r0b0t1cu/Pi1541-Simple-HAT/pi1541-simple/production/bom.csv

Designator | Footprint | Quantity | Value | LCSC Part #
D1 | LED_D3.0mm | 1 | ACT
D2 | LED_D3.0mm | 1 | PWR
J1 | PinSocket_2x20_P2.54mm_Vertical | 1 | GPIO
J2 | PinHeader_1x04_P2.54mm_Vertical | 1 | I2C Display Connector
J3 | DIN-6 | 1 | IEC1
J4 | PinHeader_1x06_P2.54mm_Vertical | 1 | IEC2
JP1 | PinHeader_1x02_P2.54mm_Vertical | 1 | BZR
LS1 | Buzzer_D12mm_H9mm_P6.5mm | 1 | Buzzer
R1, R2 | R_Axial_DIN0207_L6.3mm_D2.5mm_P10.16mm_Horizontal | 2 | 1k
SW1 | SW_Tactile_SPST_Angled_PTS645Vx83-2LFS | 1 | Select/Start
SW2 | SW_Tactile_SPST_Angled_PTS645Vx83-2LFS | 1 | Up
SW3 | SW_Tactile_SPST_Angled_PTS645Vx83-2LFS | 1 | Down
SW4 | SW_Tactile_SPST_Angled_PTS645Vx83-2LFS | 1 | Exit Folder
SW5 | SW_Tactile_SPST_Angled_PTS645Vx83-2LFS | 1 | Insert
SW6 | SW_PUSH_6mm | 1 | Reset
U1 | CONV_BOB-12009 | 1 | Level Shifter
