r0b0t1cu/Pi1541-Simple-HAT/pi1541-simple/pi1541-simple.kicad_pcb

## KiCad design pi1541-simple/pi1541-simple.kicad_pcb (2026-06-11)

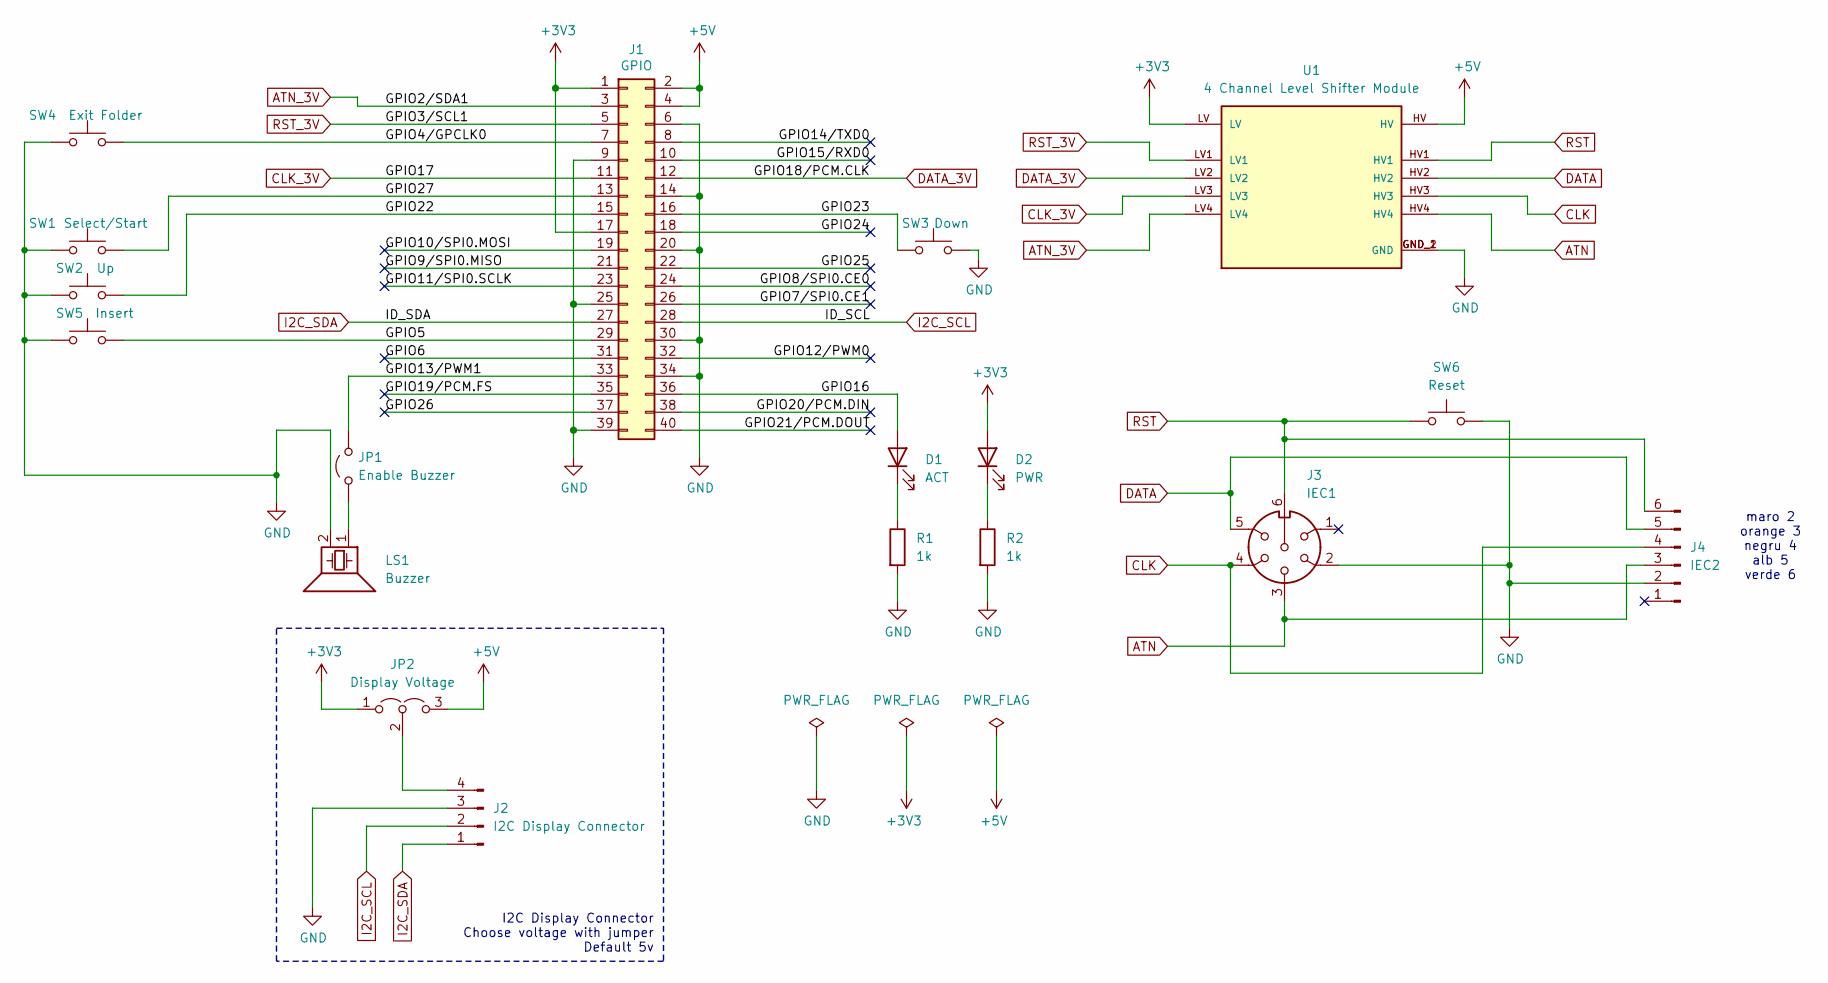
[picture p3: schematic pi1541-simple.kicad_sch, Pi1541]

Parts:
D1: ACT; LED_D3.0mm
D2: PWR; LED_D3.0mm
J1: GPIO; PinSocket_2x20_P2.54mm_Vertical
J2: I2C Display Connector; PinHeader_1x04_P2.54mm_Vertical
J3: IEC1; DIN-6
J4: IEC2; PinHeader_1x06_P2.54mm_Vertical
JP1: Enable Buzzer; PinHeader_1x02_P2.54mm_Vertical
JP2: Display Voltage; PinHeader_1x03_P2.54mm_Vertical
LS1: Buzzer; Buzzer_D14mm_H7mm_P10mm
R1, R2: 1k; R_Axial_DIN0207_L6.3mm_D2.5mm_P10.16mm_Horizontal
SW1: Select/Start; SW_Tactile_SPST_Angled_PTS645Vx83-2LFS
SW2: Up; SW_Tactile_SPST_Angled_PTS645Vx83-2LFS
SW3: Down; SW_Tactile_SPST_Angled_PTS645Vx83-2LFS
SW4: Exit Folder; SW_Tactile_SPST_Angled_PTS645Vx83-2LFS
SW5: Insert; SW_Tactile_SPST_Angled_PTS645Vx83-2LFS
SW6: Reset; SW_PUSH_6mm
U1: 4 Channel Level Shifter Module; CONV_BOB-12009; PARTREV 01

Connections:
+3V3: D2.2 (A), J1.1, J1.17, JP2.1 (A), U1.LV
+5V: J1.2, J1.4, JP2.3 (B), U1.HV
/GPIO4/GPCLK0: J1.7, SW4.2
/GPIO5: J1.29, SW5.2
/GPIO6: J1.31
/GPIO7/SPI0.CE1: J1.26
/GPIO8/SPI0.CE0: J1.24
/GPIO9/SPI0.MISO: J1.21
/GPIO10/SPI0.MOSI: J1.19
/GPIO11/SPI0.SCLK: J1.23
/GPIO12/PWM0: J1.32
/GPIO13/PWM1: J1.33, JP1.2 (B)
/GPIO14/TXD0: J1.8
/GPIO15/RXD0: J1.10
/GPIO16: D1.2 (A), J1.36
/GPIO19/PCM.FS: J1.35
/GPIO20/PCM.DIN: J1.38
/GPIO21/PCM.DOUT: J1.40
/GPIO22: J1.15, SW2.2
/GPIO23: J1.16, SW3.1
/GPIO24: J1.18
/GPIO25: J1.22
/GPIO26: J1.37
/GPIO27: J1.13, SW1.2
ATN: J3.3, J4.3, U1.HV4
ATN_3V: J1.3, U1.LV4
CLK: J3.4, J4.4, U1.HV3
CLK_3V: J1.11, U1.LV3
DATA: J3.5, J4.5, U1.HV2
DATA_3V: J1.12, U1.LV2
GND: J1.6, J1.9, J1.14, J1.20, J1.25, J1.30, J1.34, J1.39, J2.3, J3.2, J4.2, LS1.2, R1.2, R2.2, SW1.1, SW2.1, SW3.2, SW4.1, SW5.1, SW6.2, U1.GND_1 (GND), U1.GND_2 (GND)
I2C_SCL: J1.28, J2.2
I2C_SDA: J1.27, J2.1
unnamed: D1.1 (K), R1.1
unnamed: D2.1 (K), R2.1
unnamed: J2.4, JP2.2 (C)
unnamed: JP1.1 (A), LS1.1
RST: J3.6, J4.6, SW6.1, U1.HV1
RST_3V: J1.5, U1.LV1

Notes on the sheet:
I2C Display Connector Choose voltage with jumper Default 5v
maro 2 orange 3 negru 4 alb 5 verde 6

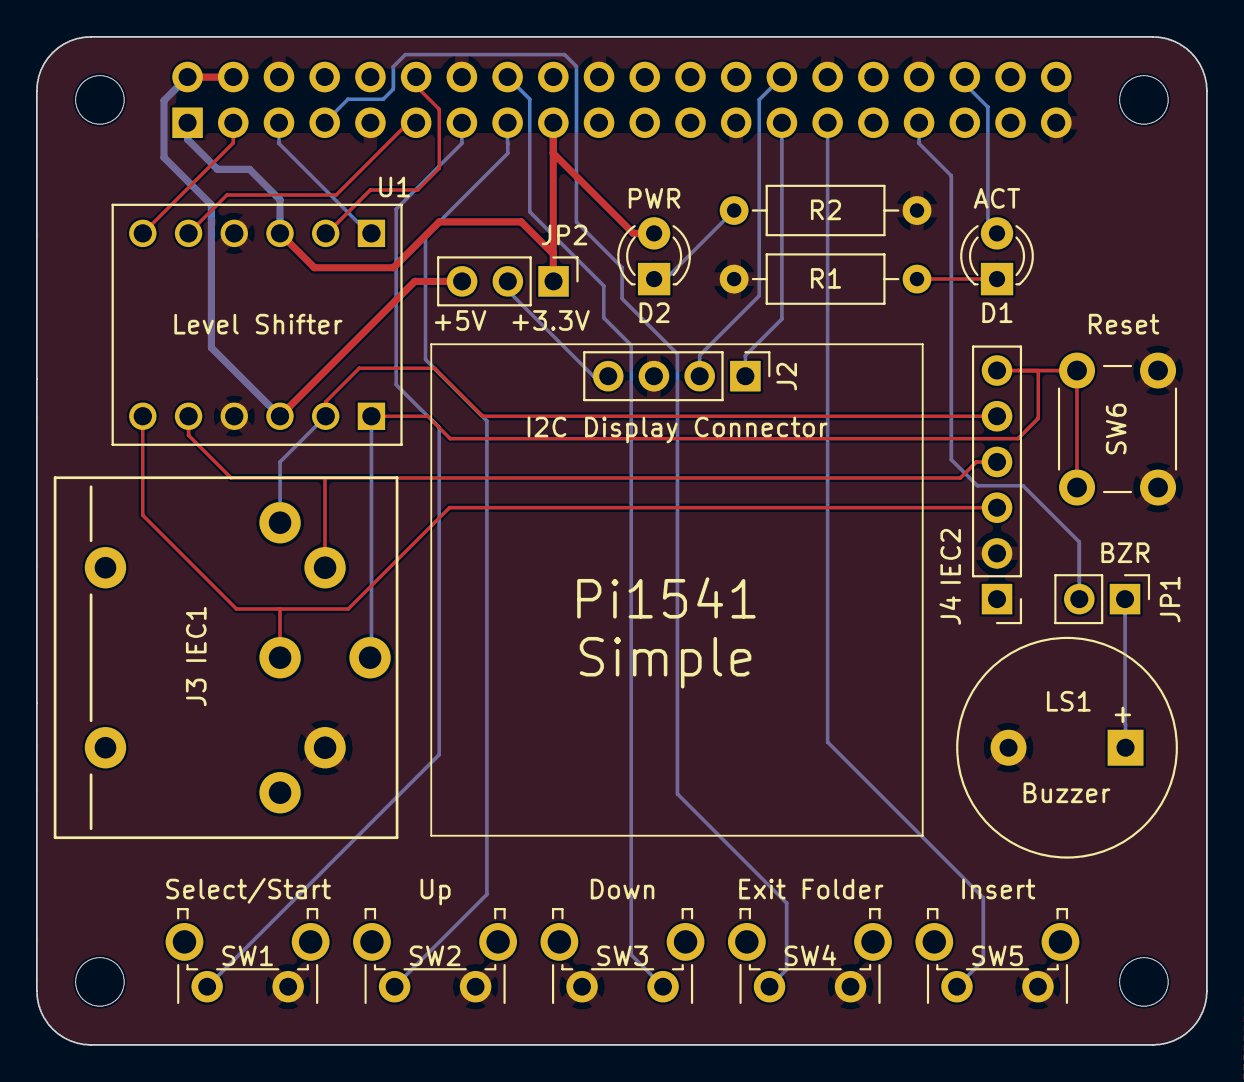
[picture p4: board pi1541-simple.kicad_pcb from above]

Board: 2 copper layers, 65.0 x 56.0 mm, 22 parts (1 on the bottom side), 24 nets.

Other parts of the board:
MH1, MH2, MH3, MH4: MountingHole_2.7mm_M2.5
