r0b0t1cu/Pi1541-Simple-HAT/(commit log)

2026-10-21 Add PCB image link to README
    Added a PCB image link from PCBWay to the README.
2026-10-21 Update README to include support link for PCBWay
2026-10-21 Revise PCB support information in README
    Updated the support section for clarity and added a direct ordering link for PCBs.
